icl-rocketry/Ricardo-FlintandSteel/Hardware/yea.pdf

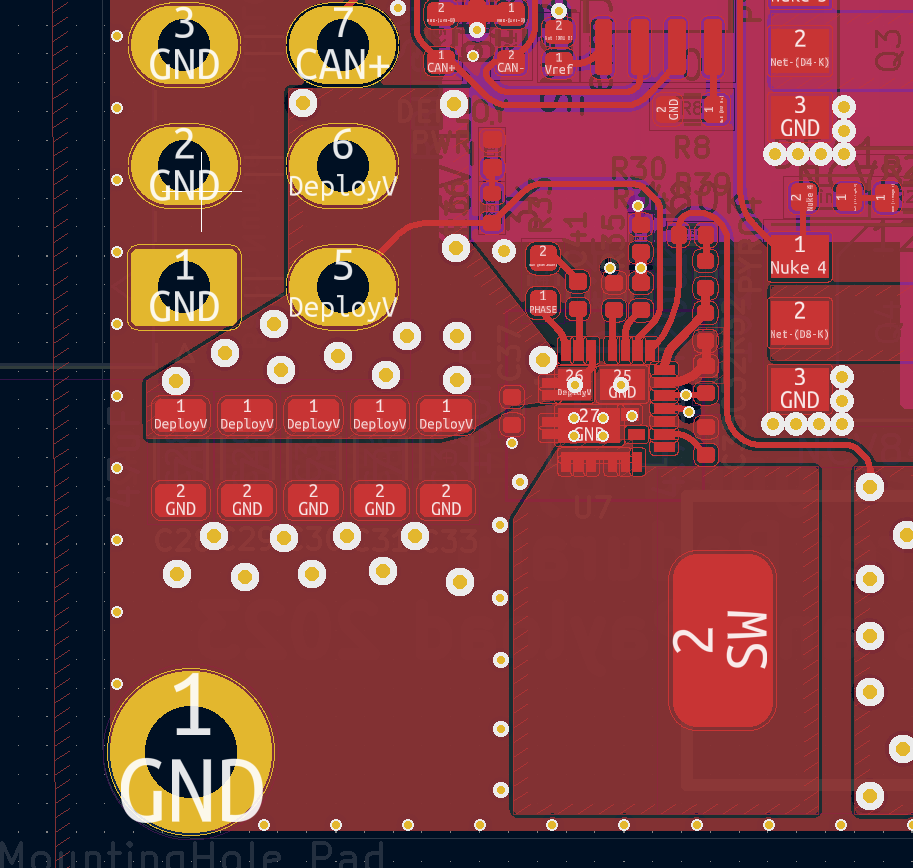
[picture p1: figure]

Can we get some pads to bypass the buck -> did some calcs, at 12v 24a cont we need to dissipate 14w, with the current thermal impedance to ambient air that puts the die at over 220c… lmao, considering a single airframe nichrome special, that puts us at 4.8w or around 70c case temp… So we def should put a bypass on there and definitely consider space for heatsinks etc

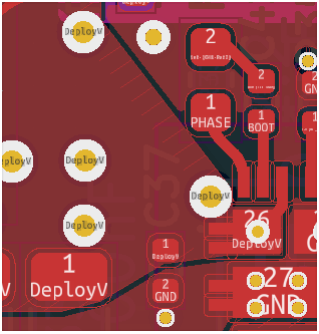
[picture p2: figure]

I also have no clue how they have rated this tiny neck to 24a, like not ur fault just the die design lol…

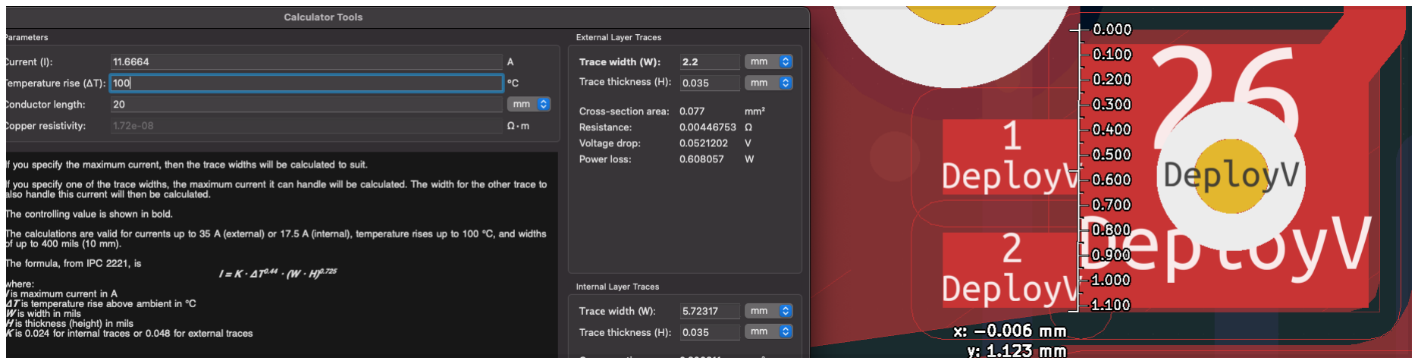
[picture p3: figure]

Might be worth considering using some of the internal plane to increase current carrying, but the via still fucks u over cos that amapcity is only like 3a

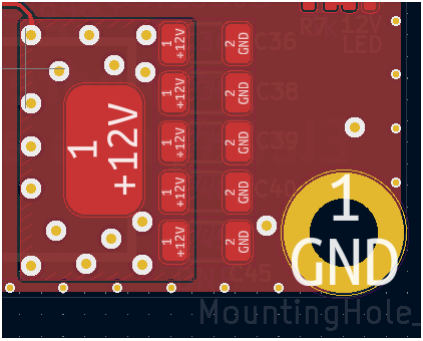
[picture p4: figure]

Ground on these caps isn’t ideal, might be fine, but may be consider moving them to the bottom instead?
v

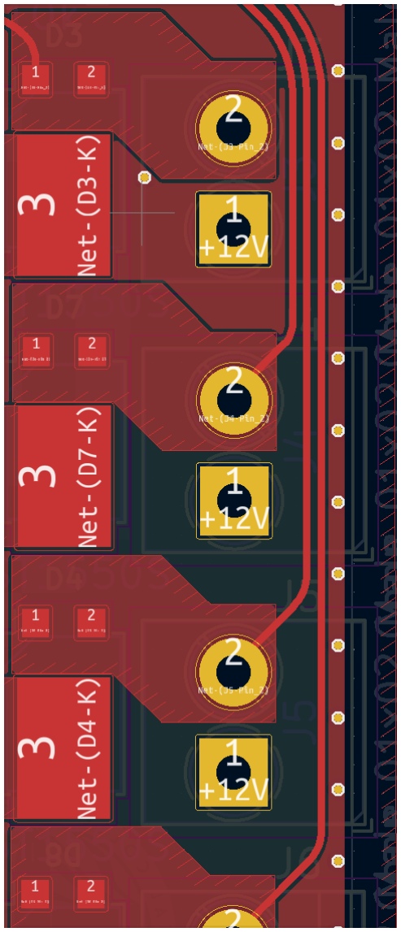
[picture p5: figure]

probably can make these copper pours as big as possible

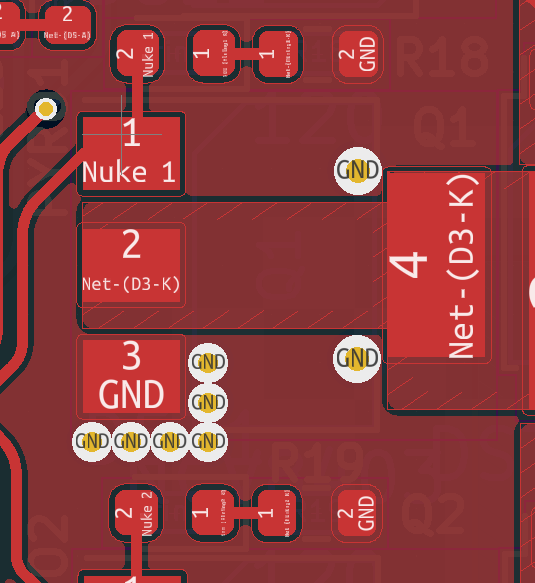
[picture p6: figure]

Id extend the Net-(D3-k) copper pour to over the side with Nuke 1 so that u maximise copper area, look at what I did for pickle

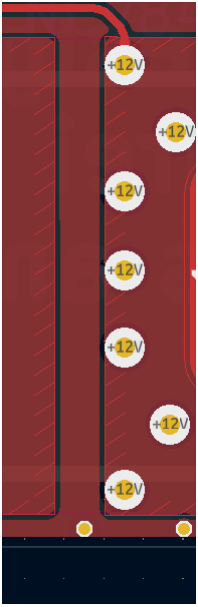
[picture p7: figure]

Maybe put a keep out between the switch planes

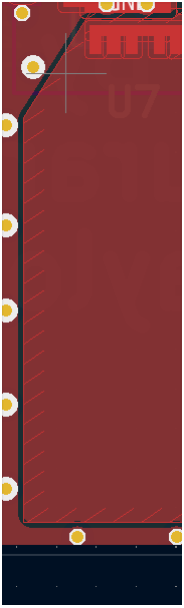
[picture p8: figure]

Maybe bring this in a bit, so the ground plane can be larger

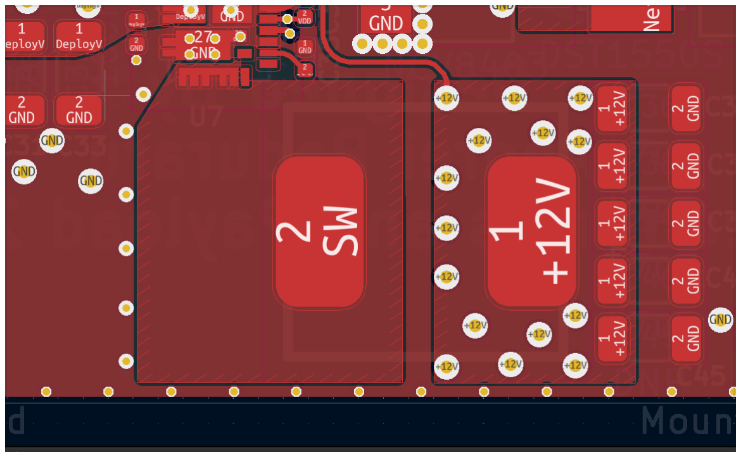
[picture p9: figure]

Might be worth to move the inductor closer to the buck? If its not fukcing ur courtyard

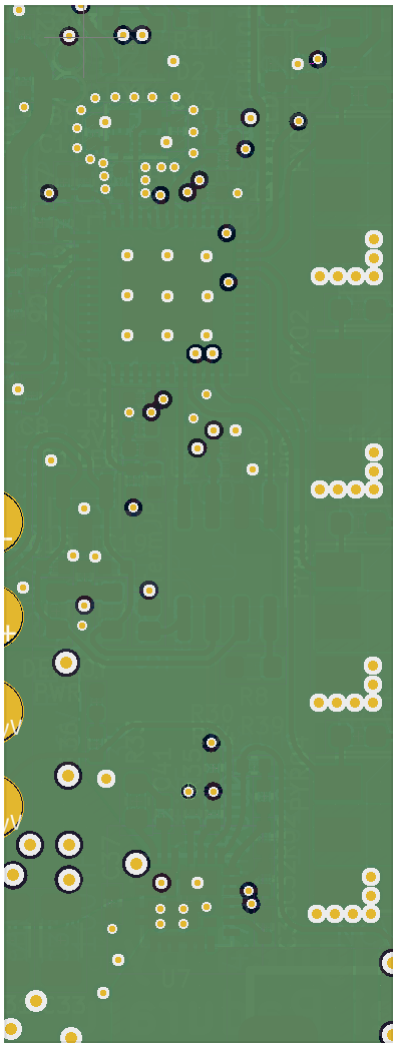
[picture p10: figure]

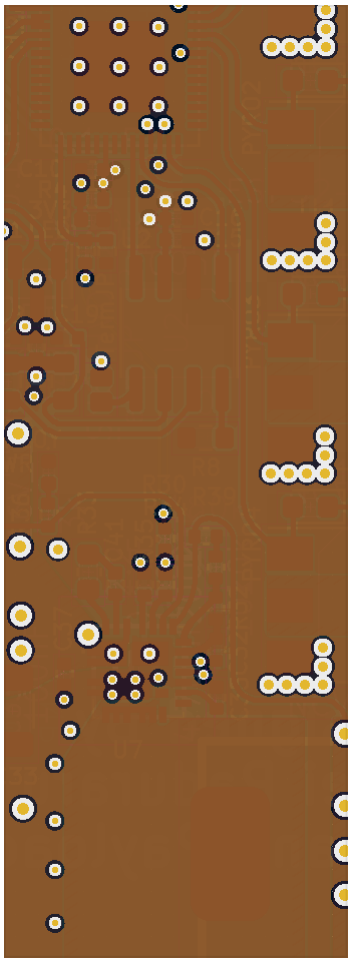
[picture p11: figure]

Via fencing
