icl-rocketry/Ricardo-FlintandSteel/Hardware/3D/flintandsteel.step

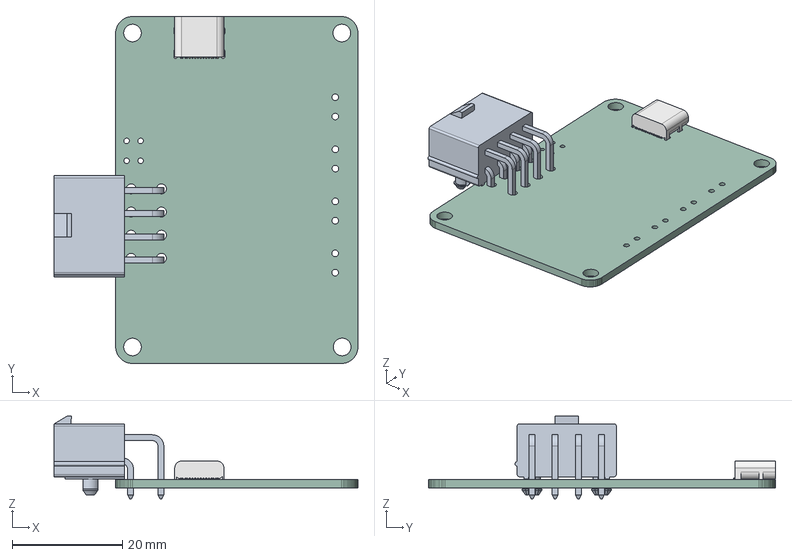
[picture p12: CAD file, 2023-09-28]
Hardware/3D/flintandsteel.step
55.2 x 63.0 x 15.0 mm
PCB
