icl-rocketry/Ricardo-FlintandSteel/Hardware/flintandsteel.kicad_pcb

## KiCad design Hardware/flintandsteel.kicad_pcb (2023-09-28)

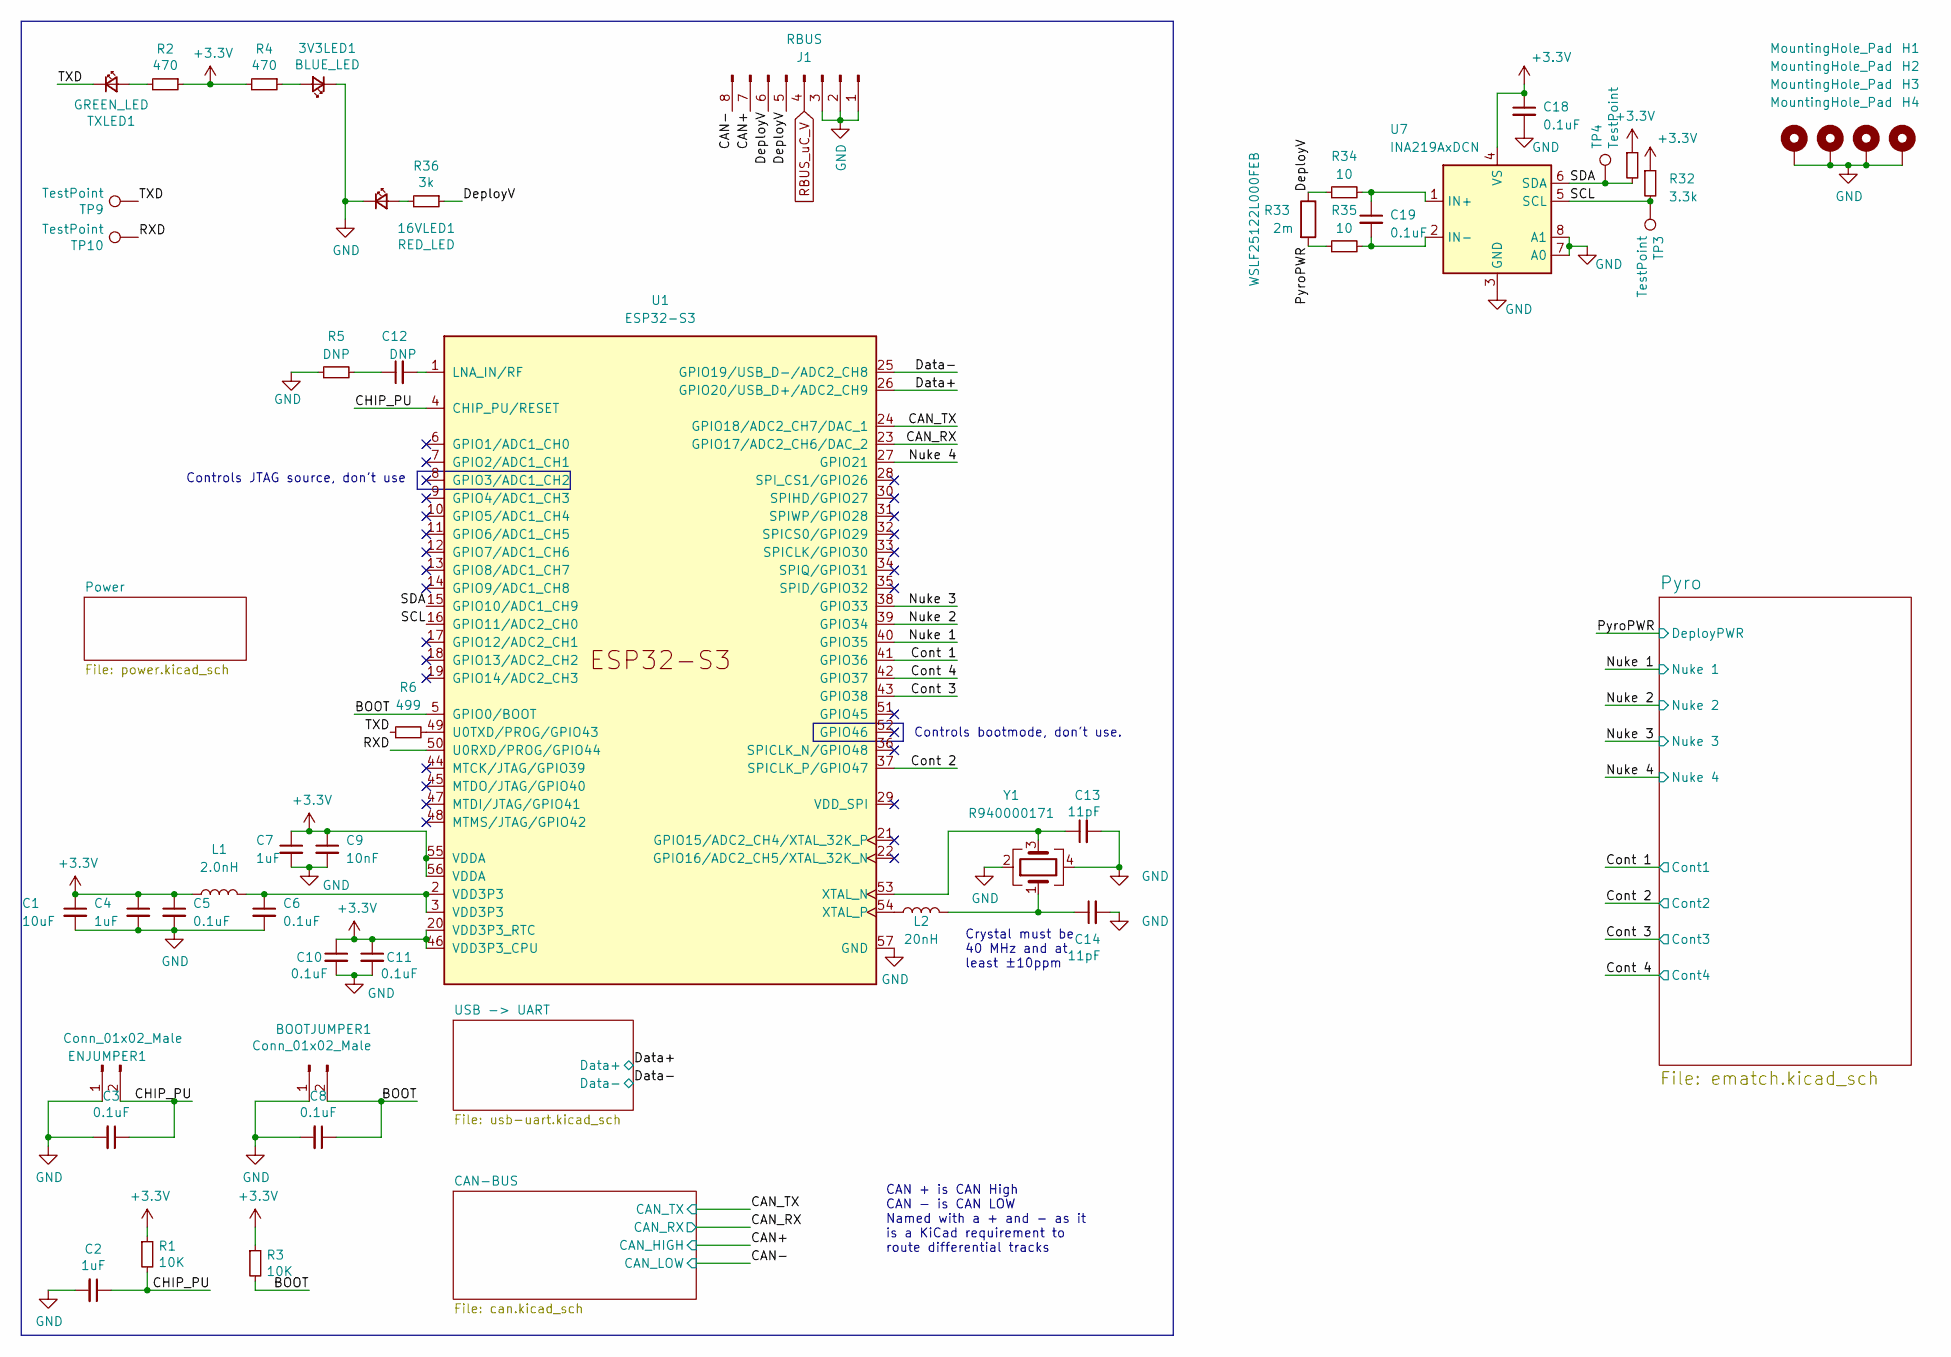
[picture p13: schematic flintandsteel.kicad_sch]

Parts:
3V3LED1: BLUE_LED; LED_0402_1005Metric
16VLED1: RED_LED; LED_0402_1005Metric
BOOTJUMPER1: Conn_01x02_Male; PinHeader_1x02_P2.54mm_Vertical
C1: 10uF; C_0402_1005Metric
C2, C4, C7: 1uF; C_0402_1005Metric
C3, C5, C6, C8, C10, C11, C18, C19: 0.1uF; C_0402_1005Metric
C9: 10nF; C_0402_1005Metric
C12: DNP; C_0402_1005Metric
C13, C14: 11pF; C_0402_1005Metric
ENJUMPER1: Conn_01x02_Male; PinHeader_1x02_P2.54mm_Vertical
H1, H2, H3: MountingHole_Pad; MountingHole_3.2mm_M3_DIN965_Pad
H4: MountingHole_Pad; MountingHole_3.2mm_M3_DIN965
J1: RBUS; Molex_Mini-Fit_Jr_5569-08A2_2x04_P4.20mm_Horizontal
L1: 2.0nH; L_0402_1005Metric
L2: 20nH; L_0402_1005Metric
R1, R3: 10K; R_0402_1005Metric
R2, R4: 470; R_0402_1005Metric
R5: DNP; R_0402_1005Metric
R6: 499; R_0402_1005Metric
R31, R32: 3.3k; R_0402_1005Metric
R33: 2m; R_2512_6332Metric_Pad1.40x3.35mm_HandSolder; Part Number WSLF25122L000FEB
R34, R35: 10; R_0402_1005Metric
R36: 3k; R_0402_1005Metric
TP3, TP4, TP9, TP10: TestPoint; TestPoint_Pad_D1.0mm
TXLED1: GREEN_LED; LED_0402_1005Metric
U1: ESP32-S3; QFN40P700X700X90-57N
U7: INA219AxDCN; SOT-23-8
Y1: R940000171; Crystal_SMD_2016-4Pin_2.0x1.6mm

Connections:
/BOOT: BOOTJUMPER1.2, C8.1, R3.2, U1.5 (GPIO0/BOOT)
/CAN+: J1.7; also elsewhere on the board
/CAN-: J1.8; also elsewhere on the board
/CAN_RX: U1.23 (GPIO17/ADC2_CH6/DAC_2); also elsewhere on the board
/CAN_TX: U1.24 (GPIO18/ADC2_CH7/DAC_1); also elsewhere on the board
/CHIP_PU: C2.1, C3.1, ENJUMPER1.2, R1.2, U1.4 (CHIP_PU/RESET)
/Cont 1: U1.41 (GPIO36); also elsewhere on the board
/Cont 2: U1.37 (SPICLK_P/GPIO47); also elsewhere on the board
/Cont 3: U1.43 (GPIO38); also elsewhere on the board
/Cont 4: U1.42 (GPIO37); also elsewhere on the board
/Data+: U1.26 (GPIO20/USB_D+/ADC2_CH9); also elsewhere on the board
/Data-: U1.25 (GPIO19/USB_D-/ADC2_CH8); also elsewhere on the board
/DeployV: J1.5, J1.6, R33.1, R34.1, R36.1
/Nuke 1: U1.40 (GPIO35); also elsewhere on the board
/Nuke 2: U1.39 (GPIO34); also elsewhere on the board
/Nuke 3: U1.38 (GPIO33); also elsewhere on the board
/Nuke 4: U1.27 (GPIO21); also elsewhere on the board
/PyroPWR: R33.2, R35.1; also elsewhere on the board
/RXD: TP10.1, U1.50 (U0RXD/PROG/GPIO44)
/SCL: R32.2, TP3.1, U1.16 (GPIO11/ADC2_CH0), U7.5 (SCL)
/SDA: R31.2, TP4.1, U1.15 (GPIO10/ADC1_CH9), U7.6 (SDA)
/TXD: R6.1, TP9.1, TXLED1.1 (K)
GND: 3V3LED1.1 (K), 16VLED1.1 (K), BOOTJUMPER1.1, C1.2, C2.2, C3.2, C4.2, C5.2, C6.2, C7.2, C8.2, C9.2, C10.2, C11.2, C13.2, C14.2, C18.2, ENJUMPER1.1, H1.1, H2.1, H3.1, H4.1, J1.1, J1.2, J1.3, R5.1, U1.57 (GND), U7.3 (GND), U7.7 (A0), U7.8 (A1), Y1.2, Y1.4; also elsewhere on the board
unnamed: 3V3LED1.2 (A), R4.1
unnamed: 16VLED1.2 (A), R36.2
unnamed: C6.1, L1.2, U1.2 (VDD3P3), U1.3 (VDD3P3)
unnamed: C12.1, R5.2
unnamed: C14.1, L2.2, Y1.1
unnamed: R2.2, TXLED1.2 (A)
unnamed: C12.2, U1.1 (LNA_IN/RF)
unnamed: R6.2, U1.49 (U0TXD/PROG/GPIO43)
unnamed: C13.1, U1.53 (XTAL_N), Y1.3
unnamed: L2.1, U1.54 (XTAL_P)
unnamed: C19.1, R34.2, U7.1 (IN+)
unnamed: C19.2, R35.2, U7.2 (IN-)
RBUS_uC_V: J1.4; also elsewhere on the board

Notes on the sheet:
Crystal must be 40 MHz and at least ±10ppm
Controls bootmode, don't use.
CAN + is CAN High CAN - is CAN LOW Named with a + and - as it is a KiCad requirement to route differential tracks
Controls JTAG source, don't use

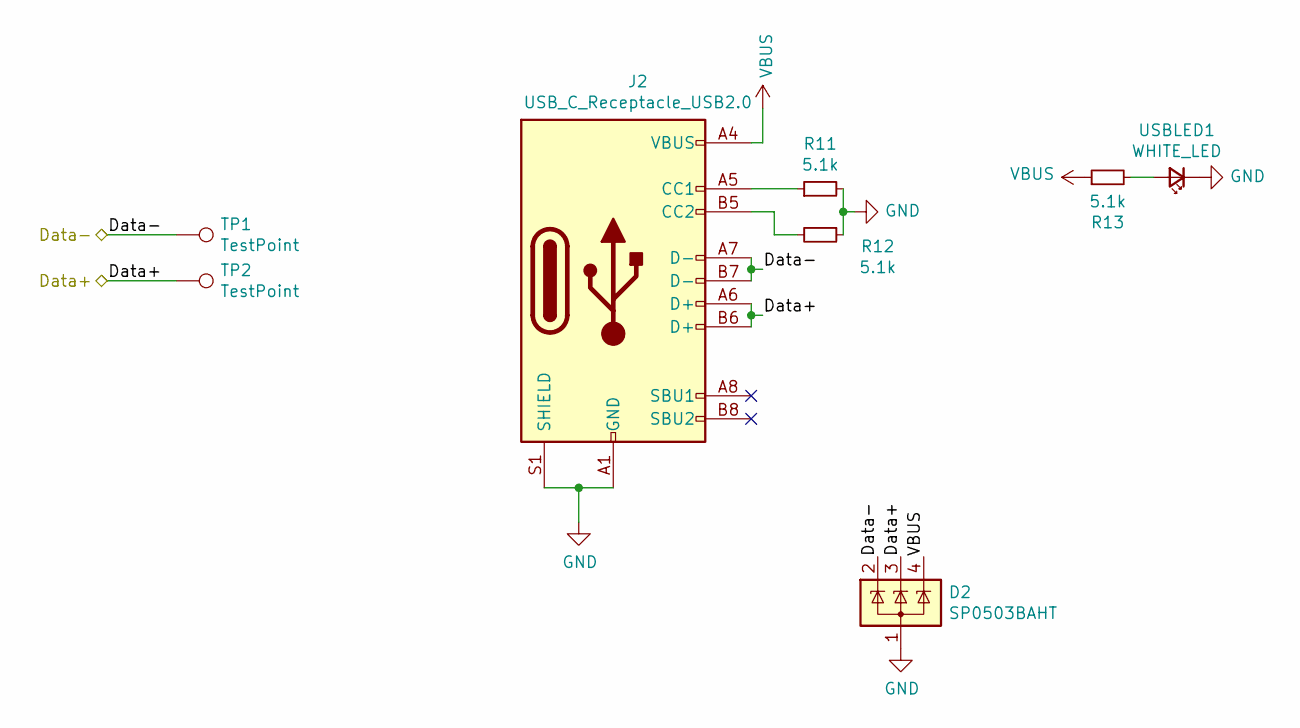
[picture p14: schematic usb-uart.kicad_sch]

Parts:
D2: SP0503BAHT; SOT-143
J2: USB_C_Receptacle_USB2.0; USB_C_Receptacle_Palconn_UTC16-G
R11, R12, R13: 5.1k; R_0402_1005Metric
TP1, TP2: TestPoint; TestPoint_Pad_D1.0mm
USBLED1: WHITE_LED; D_0402_1005Metric

Connections:
/Data+: D2.3 (K), J2.A6 (D+), J2.B6 (D+), TP2.1; also elsewhere on the board
/Data-: D2.2 (K), J2.A7 (D-), J2.B7 (D-), TP1.1; also elsewhere on the board
GND: D2.1 (A), J2.A1 (GND), J2.A12 (GND), J2.B1 (GND), J2.B12 (GND), J2.S1 (SHIELD), R11.2, R12.1, USBLED1.1 (K); also elsewhere on the board
unnamed: J2.A5 (CC1), R11.1
unnamed: J2.B5 (CC2), R12.2
unnamed: R13.2, USBLED1.2 (A)
VBUS: D2.4 (K), J2.A4 (VBUS), J2.A9 (VBUS), J2.B4 (VBUS), J2.B9 (VBUS), R13.1; also elsewhere on the board

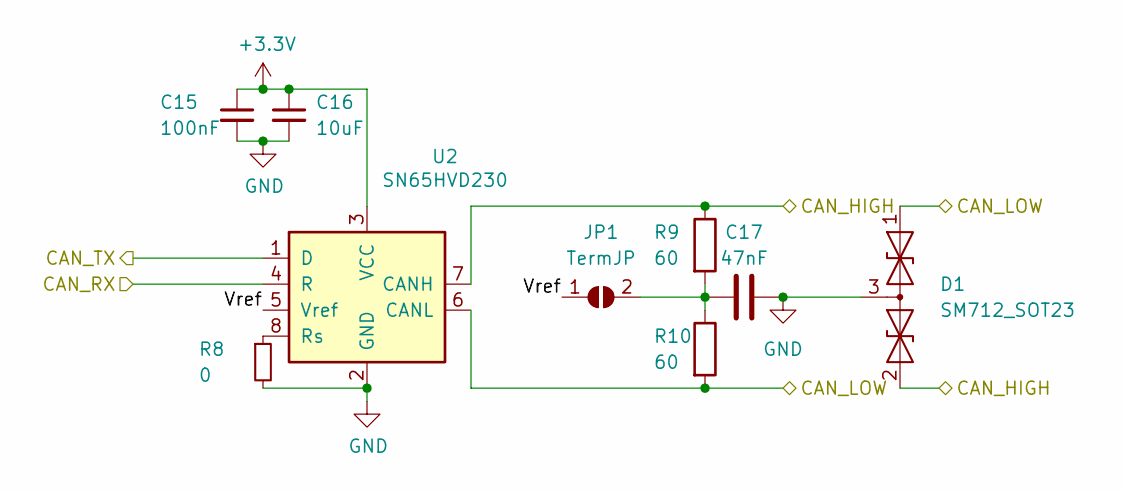
[picture p15: schematic can.kicad_sch]

Parts:
C15: 100nF; C_0402_1005Metric
C16: 10uF; C_0402_1005Metric
C17: 47nF; C_0402_1005Metric
D1: SM712_SOT23; SOT-23
JP1: TermJP; SmallerSolderJP
R8: 0; R_0603_1608Metric
R9, R10: 60; R_0603_1608Metric
U2: SN65HVD230; SOIC-8_3.9x4.9mm_P1.27mm

Connections:
/CAN+: D1.2 (A2), R9.1, U2.7 (CANH); also elsewhere on the board
/CAN-: D1.1 (A1), R10.2, U2.6 (CANL); also elsewhere on the board
/CAN-BUS/Vref: JP1.1 (A), U2.5 (Vref)
/CAN_RX: U2.4 (R); also elsewhere on the board
/CAN_TX: U2.1 (D); also elsewhere on the board
GND: C15.2, C16.2, C17.2, D1.3 (common), R8.2, U2.2 (GND); also elsewhere on the board
unnamed: C17.1, JP1.2 (B), R9.2, R10.1
unnamed: R8.1, U2.8 (Rs)

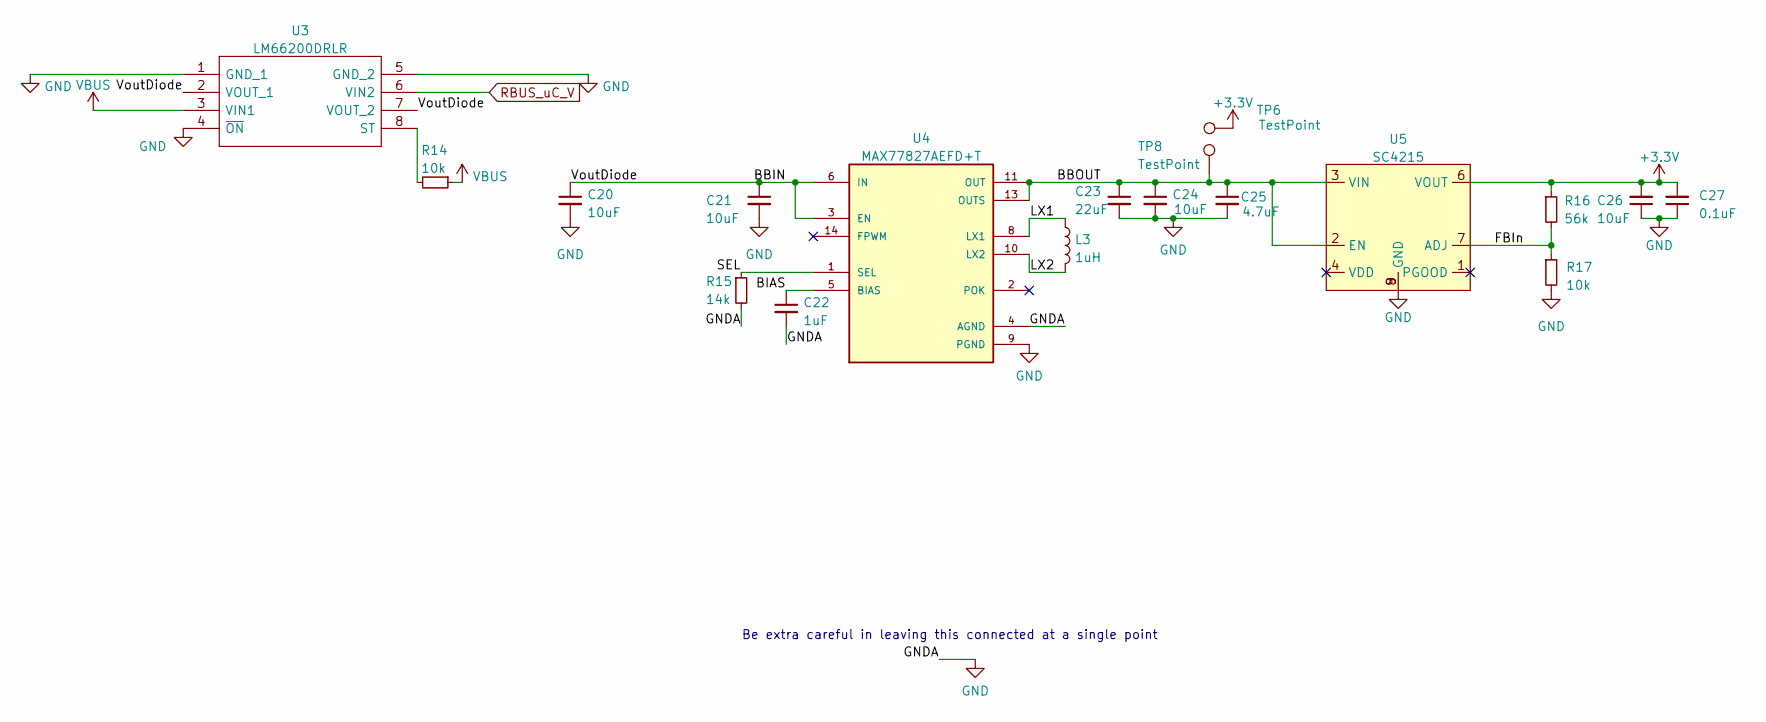
[picture p16: schematic power.kicad_sch]

Parts:
C20, C24, C26: 10uF; C_0402_1005Metric
C21: 10uF; C_0603_1608Metric
C22: 1uF; C_0402_1005Metric
C23: 22uF; C_0603_1608Metric
C25: 4.7uF; C_0402_1005Metric
C27: 0.1uF; C_0402_1005Metric
L3: 1uH; L_0805_2012Metric
R14, R17: 10k; R_0402_1005Metric
R15: 14k; R_0402_1005Metric
R16: 56k; R_0402_1005Metric
TP6, TP8: TestPoint; TestPoint_Pad_D1.0mm
U3: LM66200DRLR; SOTFL50P160X60-8N; Manufacturer_Part_Number LM66200DRLR; Mouser Part Number 595-LM66200DRLR
U4: MAX77827AEFD+T; CONV_MAX77827AEFD+T; PARTREV B
U5: SC4215; SOIC127P599X175-9N

Connections:
/Power/BBIN: C20.1, C21.1, U3.2 (VOUT_1), U3.7 (VOUT_2), U4.3 (EN), U4.6 (IN)
/Power/BBOUT: C23.1, C24.1, C25.1, TP8.1, U4.11 (OUT), U4.13 (OUTS), U5.2 (EN), U5.3 (VIN)
/Power/BIAS: C22.1, U4.5 (BIAS)
/Power/FBIn: R16.2, R17.1, U5.7 (ADJ)
/Power/LX1: L3.1, U4.8 (LX1)
/Power/LX2: L3.2, U4.10 (LX2)
/Power/SEL: R15.1, U4.1 (SEL)
GND: C20.2, C21.2, C22.2, C23.2, C24.2, C25.2, C26.1, C27.1, R15.2, R17.2, U3.1 (GND_1), U3.4 (~ON), U3.5 (GND_2), U4.4 (AGND), U4.9 (PGND), U5.8 (GND), U5.9 (GND); also elsewhere on the board
unnamed: R14.2, U3.8 (ST)
RBUS_uC_V: U3.6 (VIN2); also elsewhere on the board
VBUS: R14.1, U3.3 (VIN1); also elsewhere on the board

Notes on the sheet:
Be extra careful in leaving this connected at a single point

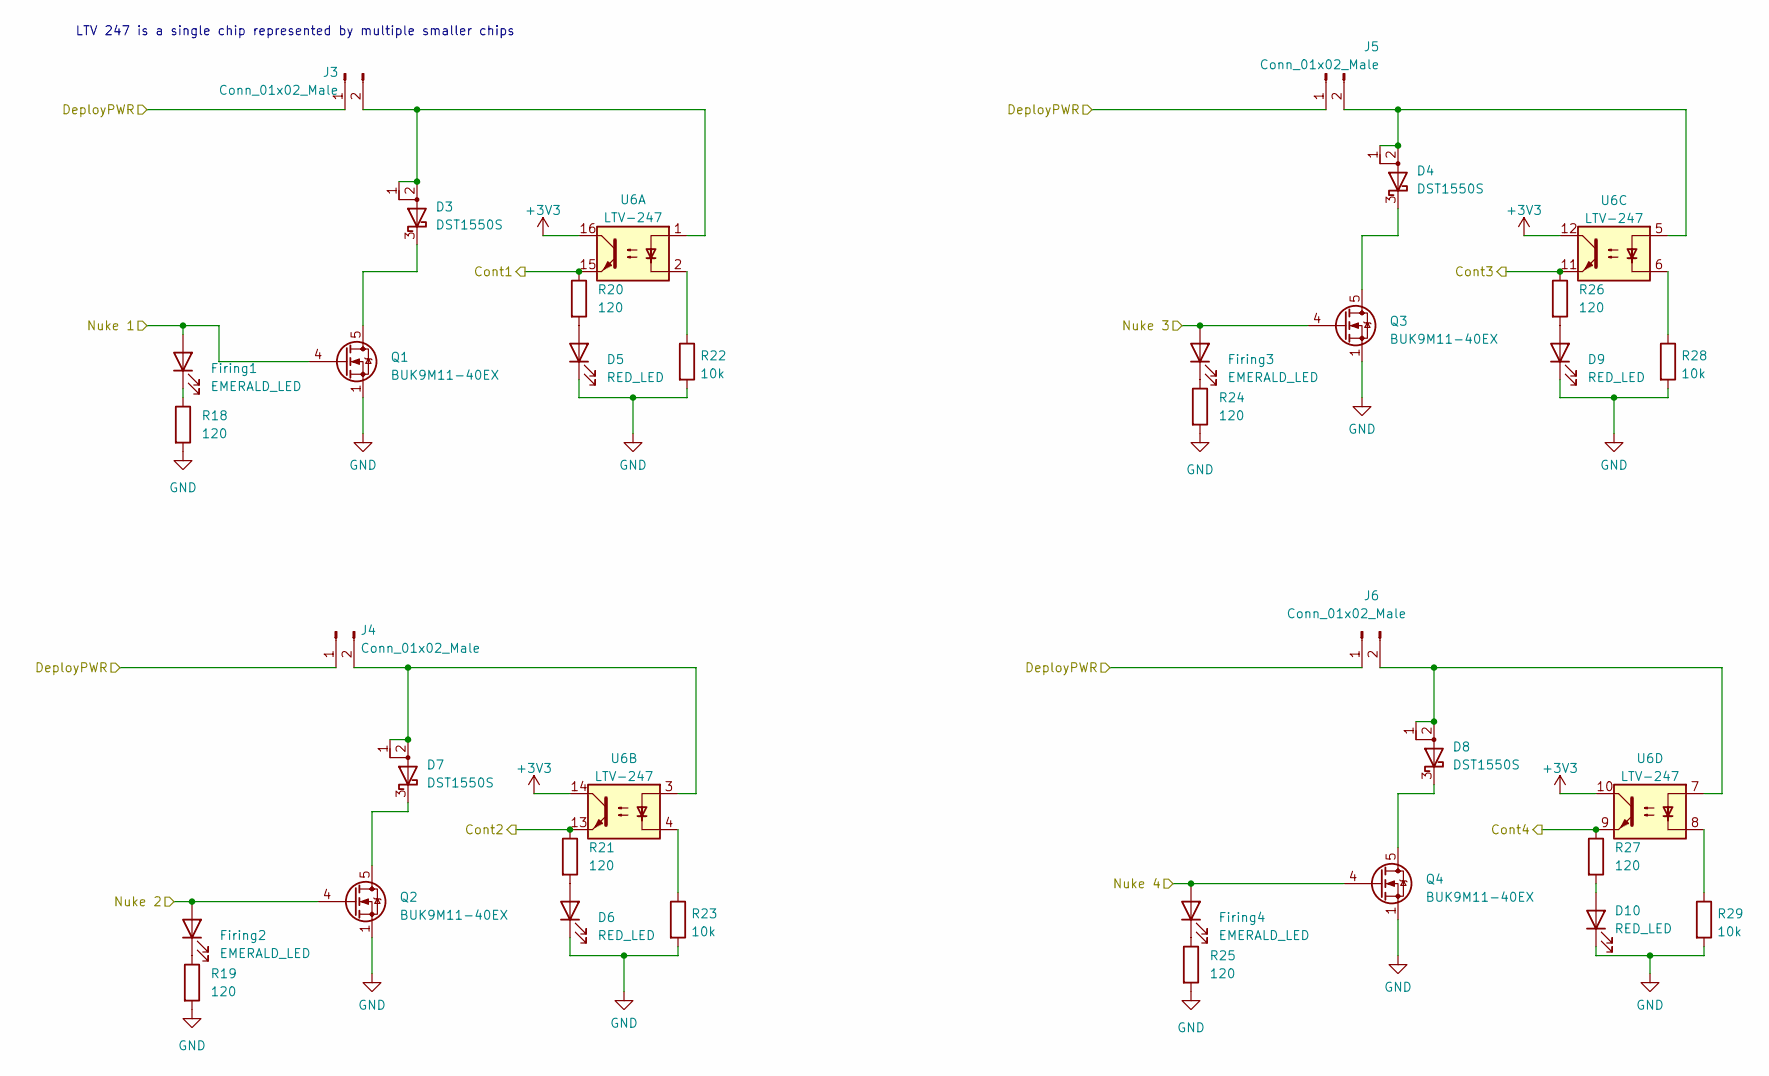
[picture p17: schematic ematch.kicad_sch]

Parts:
D3, D4, D7, D8: DST1550S; TO-277B
D5, D6, D9, D10: RED_LED; LED_0603_1608Metric
Firing1, Firing2, Firing3, Firing4: EMERALD_LED; LED_0402_1005Metric
J3, J4, J5, J6: Conn_01x02_Male; TerminalBlock_Phoenix_PT-1,5-2-3.5-H_1x02_P3.50mm_Horizontal
Q1, Q2, Q3, Q4: BUK9M11-40EX; LFPAK33
R18, R19, R24, R25: 120; R_0402_1005Metric
R20, R21, R26, R27: 120; R_0603_1608Metric
R22, R23, R28, R29: 10k; R_0603_1608Metric
U6: LTV-247; SOP-16_4.4x10.4mm_P1.27mm

Connections:
/Cont 1: R20.1, U6.15; also elsewhere on the board
/Cont 2: R21.1, U6.13; also elsewhere on the board
/Cont 3: R26.1, U6.11; also elsewhere on the board
/Cont 4: R27.1, U6.9; also elsewhere on the board
/Nuke 1: Firing1.2 (A), Q1.4 (G); also elsewhere on the board
/Nuke 2: Firing2.2 (A), Q2.4 (G); also elsewhere on the board
/Nuke 3: Firing3.2 (A), Q3.4 (G); also elsewhere on the board
/Nuke 4: Firing4.2 (A), Q4.4 (G); also elsewhere on the board
/PyroPWR: J3.1, J4.1, J5.1, J6.1; also elsewhere on the board
GND: D5.1 (K), D6.1 (K), D9.1 (K), D10.1 (K), Q1.1 (S), Q1.2 (S), Q1.3 (S), Q2.1 (S), Q2.2 (S), Q2.3 (S), Q3.1 (S), Q3.2 (S), Q3.3 (S), Q4.1 (S), Q4.2 (S), Q4.3 (S), R18.2, R19.2, R22.2, R23.2, R24.2, R25.2, R28.2, R29.2; also elsewhere on the board
unnamed: D3.3 (K), Q1.5 (D)
unnamed: D4.3 (K), Q3.5 (D)
unnamed: D5.2 (A), R20.2
unnamed: D6.2 (A), R21.2
unnamed: D7.3 (K), Q2.5 (D)
unnamed: D8.3 (K), Q4.5 (D)
unnamed: D9.2 (A), R26.2
unnamed: D10.2 (A), R27.2
unnamed: Firing1.1 (K), R18.1
unnamed: Firing2.1 (K), R19.1
unnamed: Firing3.1 (K), R24.1
unnamed: Firing4.1 (K), R25.1
unnamed: D3.1 (A), D3.2 (A), J3.2, U6.1
unnamed: D7.1 (A), D7.2 (A), J4.2, U6.3
unnamed: D4.1 (A), D4.2 (A), J5.2, U6.5
unnamed: D8.1 (A), D8.2 (A), J6.2, U6.7
unnamed: R22.1, U6.2
unnamed: R23.1, U6.4
unnamed: R28.1, U6.6
unnamed: R29.1, U6.8

Notes on the sheet:
LTV 247 is a single chip represented by multiple smaller chips

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
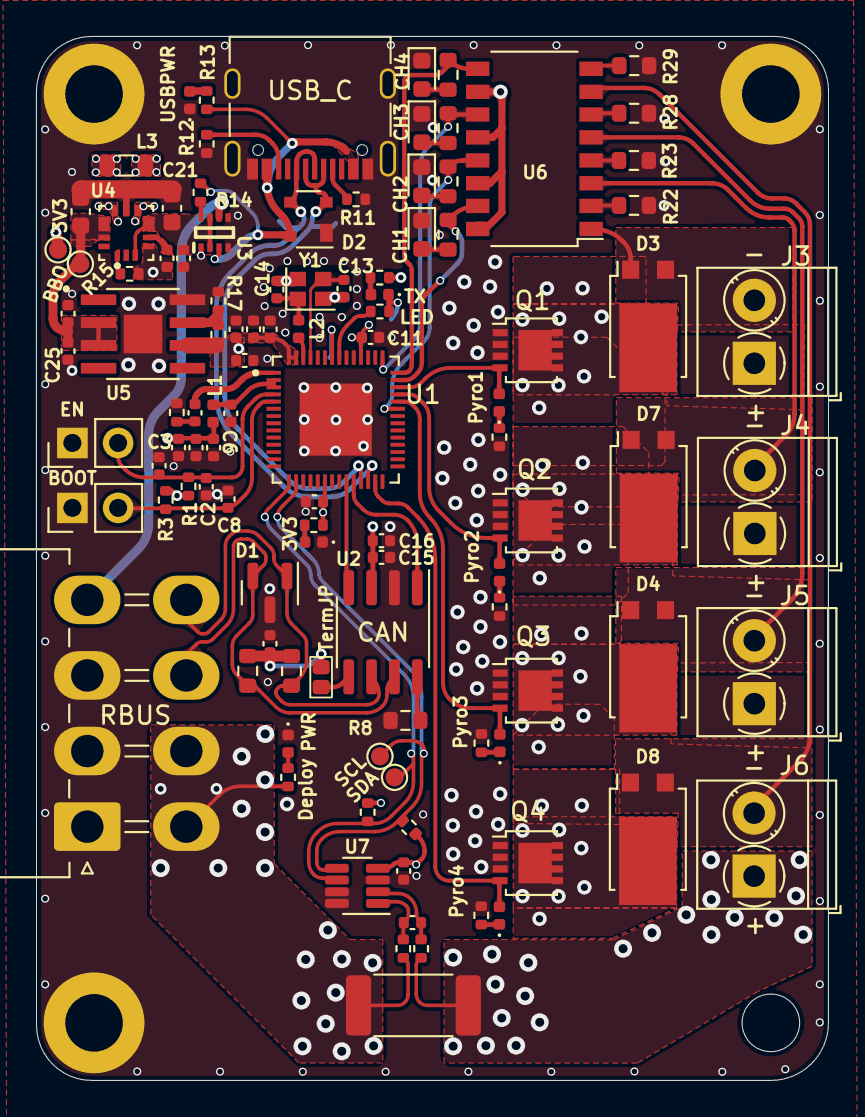
[picture p18: board flintandsteel.kicad_pcb from above]

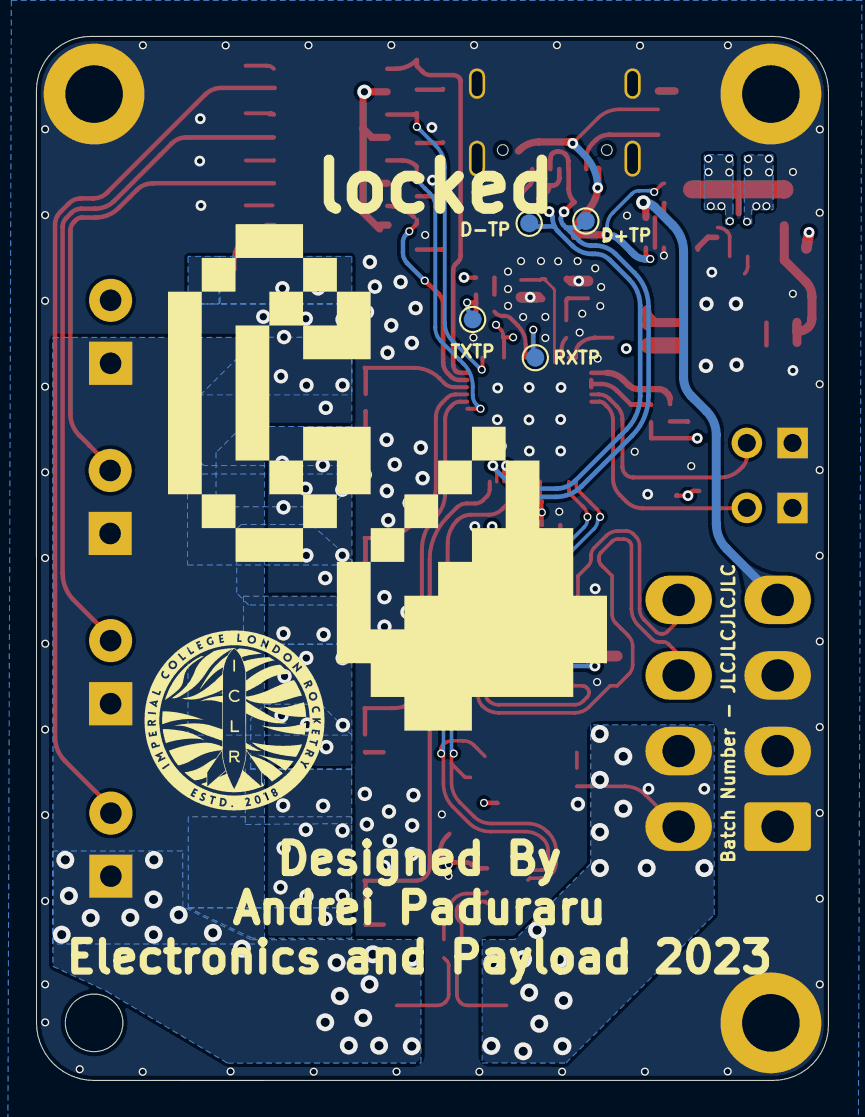
[picture p19: board flintandsteel.kicad_pcb from below]

Board: 4 copper layers, 44.0 x 58.0 mm, 115 parts (4 on the bottom side), 72 nets.
