icl-rocketry/Ricardo-FlintandSteel/(commit log)

2021-12-04 Initial rev of e-match board (adapted from sensorboard schematic)
    Replaced all the ADCs with 4 e-match circuits
    [AMCA31-2R450G-S1F-T3.step, IMU.sch, Mainboard.kicad_pcb, Mainboard.sch, Nukes.sch, analogue.sch, analogueI2C.sch, ematch.sch]
2021-12-04 Added arming LED
    Arming LED is to turn ON when circuit is primed - after 5s of charging capacitor / boot
    A more precise way to do this would probably be to hook up another MOSFET to regulate input voltage (so you can control capacitor charging from the ESP)
    [Mainboard.sch]
2021-12-04 Added arming LED 2
    Github Desktop threw me a weird error, so here's a second commit
    [Mainboard.sch]
2021-12-04 Schematic comments + minor fixes
    [Mainboard.sch]
2021-12-15 Updated number of ematches
    Increased e match count from 4->6 as requested (2 spares)
    [Mainboard.sch, ematch.sch]
2022-03-12 removed other files
    [AMCA31-2R450G-S1F-T3.step, E_match_board_writing.sch, IMU.sch, Mainboard.kicad_pcb, Mainboard.sch, Nukes.sch, Ricardo_Nov_7_larger_usb_c.sch, analogue.sch]
2022-04-17 Unzipped files + implemented schematic review feedback
    [Mainboard_2022.kicad_pcb, Mainboard_construction.kicad_pcb, Mainboard_to_update.kicad_sch, ematch.kicad_sch]
2022-05-14 changed LDO passives, changed filestructure
    [Mainboard.kicad_pcb, Mainboard.kicad_sch, Mainboard_construction.kicad_pcb, Mainboard_to_update.kicad_sch]
2022-05-14 removed ground traces
    [Mainboard.kicad_pcb, Mainboard.kicad_sch]
2022-05-16 routed thicker 24V traces and moved some components
    [Mainboard.kicad_pcb, Mainboard.kicad_sch]
2022-05-17 changed schottky diode FP and rearranged mosfets + screw terminals
    [Mainboard.kicad_pcb, Mainboard.kicad_sch, ematch.kicad_sch]
2022-05-18 completed layout for screw terminals, moved some LEDs
    [Mainboard.kicad_pcb, Mainboard.kicad_sch, ematch.kicad_sch]
2022-05-18 initial routing of cont and nuke traces
    [Mainboard.kicad_pcb, Mainboard.kicad_sch]
2022-05-21 completed routing, changed antenna for U.FL connector
    [Mainboard.kicad_pcb, Mainboard.kicad_sch, ematch.kicad_sch]
2022-05-21 created GND planes and fixed zone priority to prevent shorting nets
    [Mainboard.kicad_pcb, Mainboard.kicad_sch, ematch.kicad_sch]
2022-05-24 Made front silkscreen intelligible
    [Mainboard.kicad_pcb]
2022-05-24 Added flint and steel name and picture
    [Mainboard.kicad_pcb]
2022-05-24 Added writepad and iclr logo to back silkscreen
    [Mainboard.kicad_pcb]
2022-05-24 Removed thermal relief on RBUS
    [Mainboard.kicad_pcb]
2022-05-31 Added names on back silkscreen, implemented Kiran's mini review
    [Mainboard.kicad_pcb]
2022-05-31 fixed front silkscreen after board re-dimension
    [Mainboard.kicad_pcb]
2022-06-21 Added version numbering
    [Mainboard.kicad_pcb]
2022-06-28 Changed 24V LED resistor value
    [Mainboard.kicad_sch]
2022-06-29 Changed LDO symbol
    [Mainboard.kicad_sch]
2022-07-06 Changed boot and EN jumper caps
    [Mainboard.kicad_sch]
2022-07-06 set values for can passives
    [Mainboard.kicad_sch]
2022-07-06 fixed unroute nets and changed LED resistor values
    [Mainboard.kicad_pcb, Mainboard.kicad_sch, ematch.kicad_sch]
2022-07-06 moved nuke channels from input only pins, changed resistor values
    [Mainboard.kicad_pcb, Mainboard.kicad_sch]
2022-07-06 forgot to stage this in the last commit
    [Mainboard.kicad_sch, ematch.kicad_sch]
2022-07-08 Changed autoprogrammer caps to 1uF
    [Mainboard.kicad_sch]
2022-07-11 Added ICLR logo and fixed antenna line impedance
    [Mainboard.kicad_pcb]
2022-07-14 Removed CAN resistors
    [Mainboard.kicad_pcb, Mainboard.kicad_sch]
2022-07-21 DRC fixes
    [Mainboard.kicad_pcb]
2022-07-26 Changed ESP32 pin assignment from special IO pins
    [Mainboard.kicad_pcb, Mainboard.kicad_sch, ematch.kicad_sch]
2022-07-29 Fixed pin assigments again
    [Mainboard.kicad_pcb, Mainboard.kicad_sch]
2022-08-02 updated leds on ematch board and re-routed
    [BOM-Mainboard.csv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]
2022-09-09 fixed canbus;
2022-10-04 remove serial print which was causing issues over serial debug
2023-02-24 restructured folders, updated to s3 template, scaled down to 4 channels
    [BOM-Mainboard.csv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]
2023-02-24 whatever gitkraken missed
    [ricpart.csv]
2023-03-14 schematic done? + footprints assigned
    [buckC.kicad_sch, can.kicad_sch, ematch.kicad_sch, flintandsteel.kicad_pcb, flintandsteel.kicad_sch, power.kicad_sch, usb-uart.kicad_sch]
2023-03-15 started pyro channel layout
    [flintandsteel.kicad_pcb, flintandsteel.kicad_sch]
2023-03-16 pyro channels & tiny buck passives
    [buckC.kicad_sch, flintandsteel.kicad_pcb]
2023-03-18 I had to get back out of bed to push this commit
    [can.kicad_sch, flintandsteel.kicad_pcb, flintandsteel.kicad_sch]
2023-03-27 I don't remember what I did but I have to move these files to my desktop
    [flintandsteel.kicad_pcb]
2023-03-28 High power side nearly done
    [buckC.kicad_sch, ematch.kicad_sch, flintandsteel.kicad_pcb]
2023-03-29 high V side finished, CAN circuit and ESP left to place
    [buckC.kicad_sch, ematch.kicad_sch, flintandsteel.kicad_pcb, flintandsteel.kicad_sch, usb-uart.kicad_sch]
2023-03-30 finished? (pre-review)
    [buckC.kicad_sch, ematch.kicad_sch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]
2023-03-30 changed buck FB resistors to actual values
    [buckC.kicad_sch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]
2023-06-11 no buck, technically complete but I still want to make some changes
    [flintandsteel.kicad_pcb, flintandsteel.kicad_sch]
2023-06-13 removed can caps, better via stitching, fini?
    [can.kicad_sch, flintandsteel.kicad_pcb, flintandsteel.kicad_sch]
2023-06-13 forgor about the gerbers but whatever
    [flintandsteel-B_Cu.gbl, flintandsteel-B_Mask.gbs, flintandsteel-B_Paste.gbp, flintandsteel-B_Silkscreen.gbo, flintandsteel-Edge_Cuts.gm1, flintandsteel-F_Cu.gtl, flintandsteel-F_Mask.gts, flintandsteel-F_Paste.gtp]
2023-07-06 Kiran's review
    [flintandsteel.kicad_pcb, flintandsteel.kicad_sch]
2023-08-15 removing software
    [bom.csv, designators.csv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]
2023-08-15 adding firmware finally
    [app3M_fat9M_16MB.csv, bare_minimum_2MB.csv, default.csv, default_16MB.csv, default_8MB.csv, default_ffat.csv, ffat.csv, huge_app.csv]
2023-08-15 fixed submodules (how does this happen every time??)
    [app3M_fat9M_16MB.csv, bare_minimum_2MB.csv, default.csv, default_16MB.csv, default_8MB.csv, default_ffat.csv, ffat.csv, huge_app.csv]
2023-08-15 forgor arduino submodule, added can interface, f&s fw done lol?
2023-08-16 CAN pins were wrong, systemflags include was in the wrong order
    [system.cpp, system.h]
2023-08-18 changed mosfets and added current sense circuit, layout not done
    [ematch.kicad_sch, flintandsteel.kicad_pcb, flintandsteel.kicad_sch]
2023-08-20 mostly finished new power layout, needs some vias and i2c routing
    [ematch.kicad_sch, flintandsteel.kicad_pcb, flintandsteel.kicad_sch, usb-uart.kicad_sch]
2023-08-21 some zone priorities
    [flintandsteel.kicad_pcb]
2023-09-05 v2.1 ordering
    [bom.csv, designators.csv, ematch.kicad_sch, flintandsteel.kicad_pcb, flintandsteel.kicad_sch, positions.csv, usb-uart.kicad_sch]
2023-09-28 started INA219 sensor driver,pulled submodule main
    [bom.csv, buckC.kicad_sch, can.kicad_sch, designators.csv, ematch.kicad_sch, flintandsteel.kicad_pcb, flintandsteel.kicad_sch, flintandsteel.step]
2023-09-28 removed INA219, fixed Config folder
    [INA219.cpp, INA219.h]
2023-10-31 submodules track properly now
2023-11-10 current sensor finally works
